robinolejnik/bosch-kf163-control/README.md

# bosch-kf163-control
Replacement PLL/TGA PCB to control Bosch KF83/KF163/KF453/KF165 radios
