robinolejnik/bosch-kf163-control/hardware/bosch-kf163-control.pdf

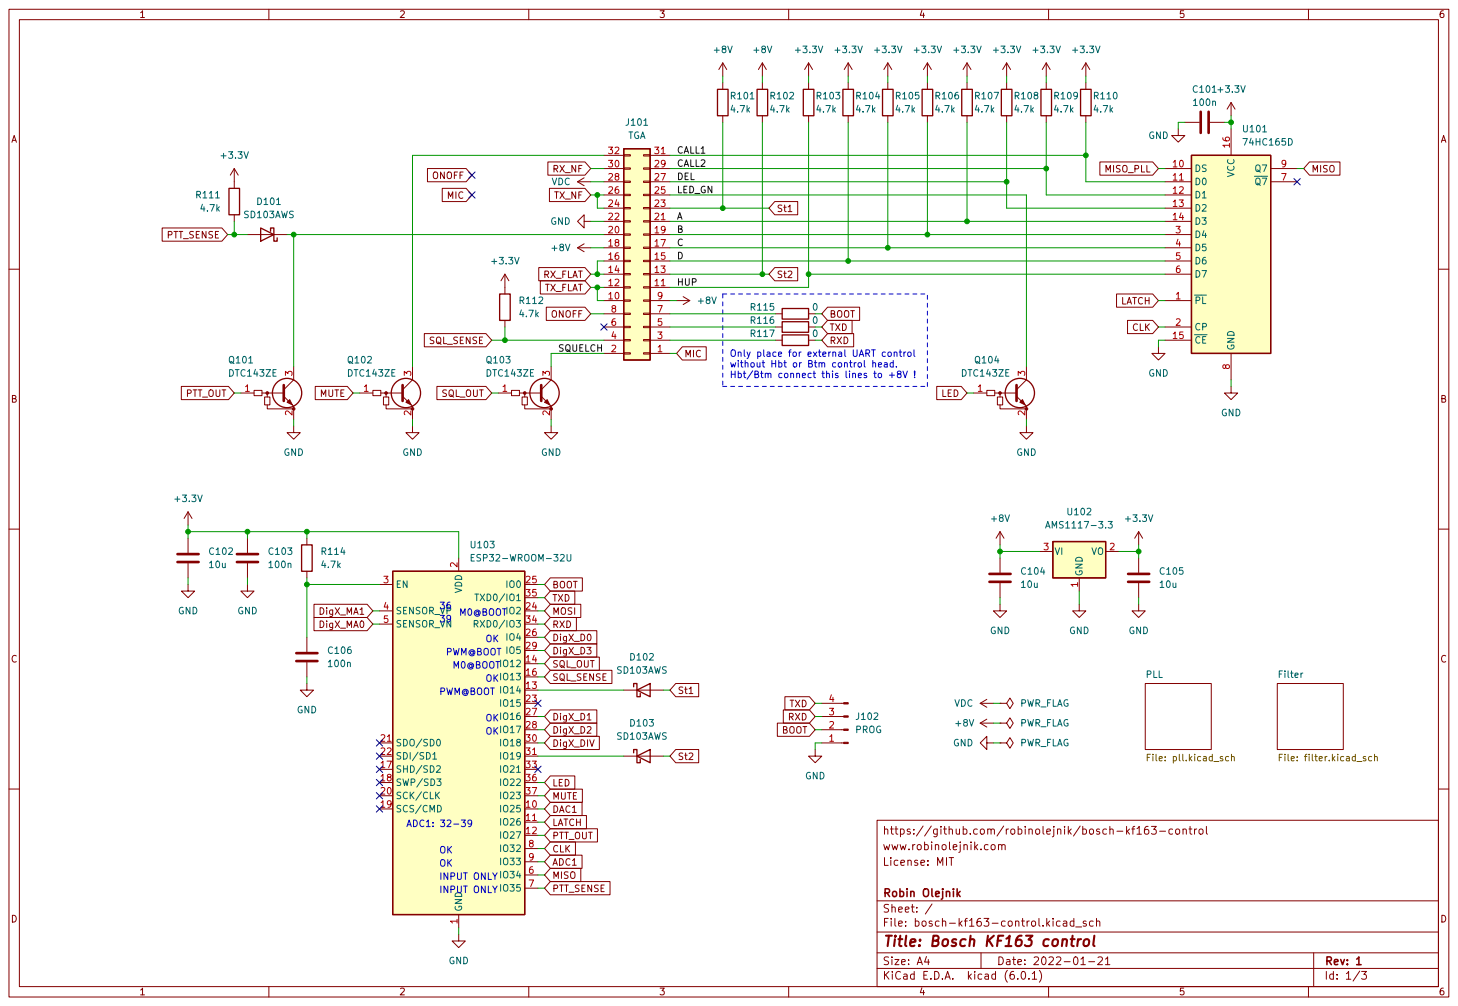
[picture p1: page 1]

CALL2 AHUP

18 +8V 16 SQUELCH 2 | 17 C

2 SCK/CLK 20 SDO/SD0 21 SDI/SD1 22

License: MIT www.robinolejnik.com

File: bosch-kf163-control.kicad_sch Sheet: / Robin Olejnik

Id: 1/3 Title: Bosch KF163 control

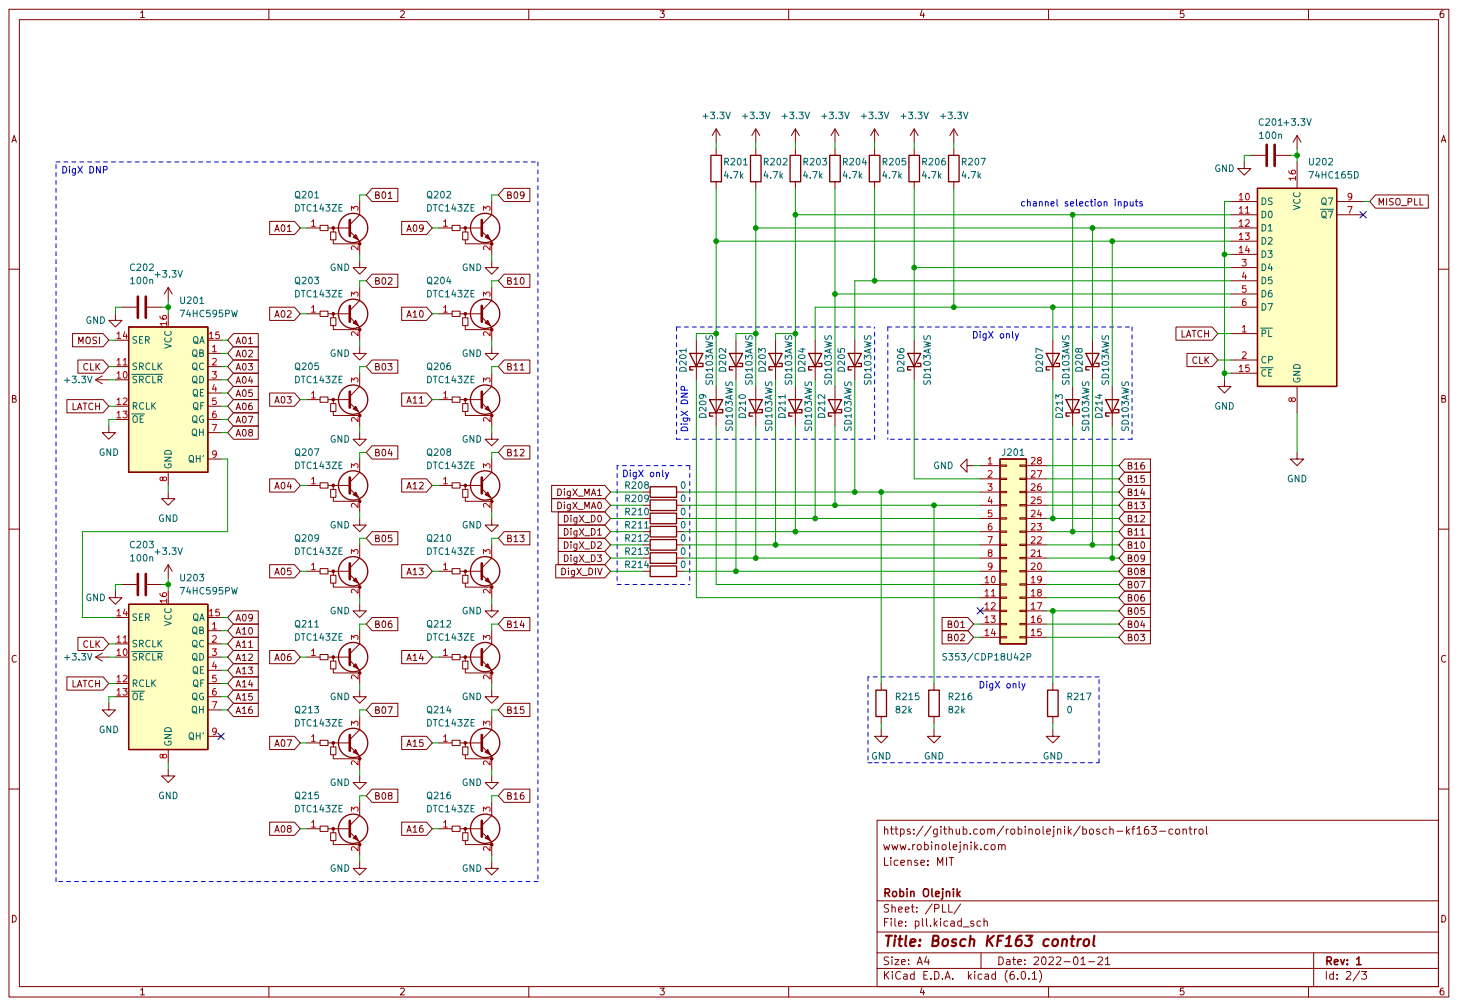
[picture p2: page 2]

2 3 Q204 DTC143ZE QB 1 ~{SRCLR} 10 SRCLK 11 RCLK 12 ~{OE} 13 SER 14 QA 15 VCC 16 QC 2 QD 3 QE 4 QF 5 QG 6 QH 7 GND

11
12

https://github.com/robinolejnik/bosch-kf163-control
License: MIT www.robinolejnik.com

File: pll.kicad_sch Sheet: /PLL/ Robin Olejnik

Id: 2/3 Title: Bosch KF163 control

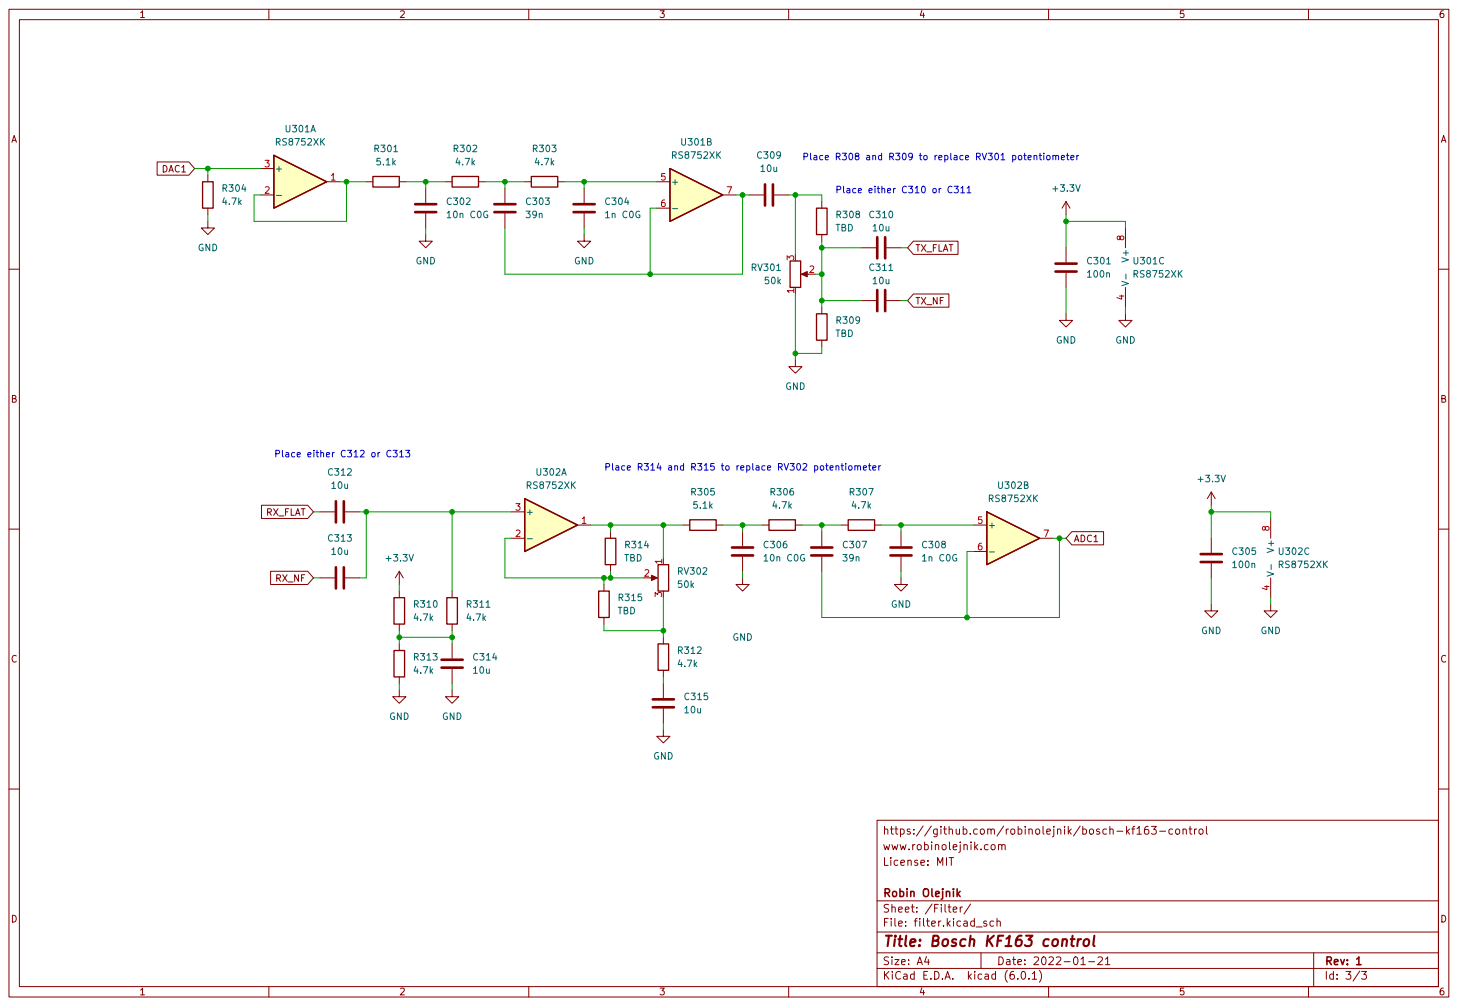
[picture p3: page 3]

https://github.com/robinolejnik/bosch-kf163-control GND GND

License: MIT www.robinolejnik.com

File: filter.kicad_sch Sheet: /Filter/ Robin Olejnik

Id: 3/3 Title: Bosch KF163 control
