robinolejnik/bosch-kf163-control/hardware/bosch-kf163-control.kicad_pcb

## KiCad design hardware/bosch-kf163-control.kicad_pcb (2022-01-21)

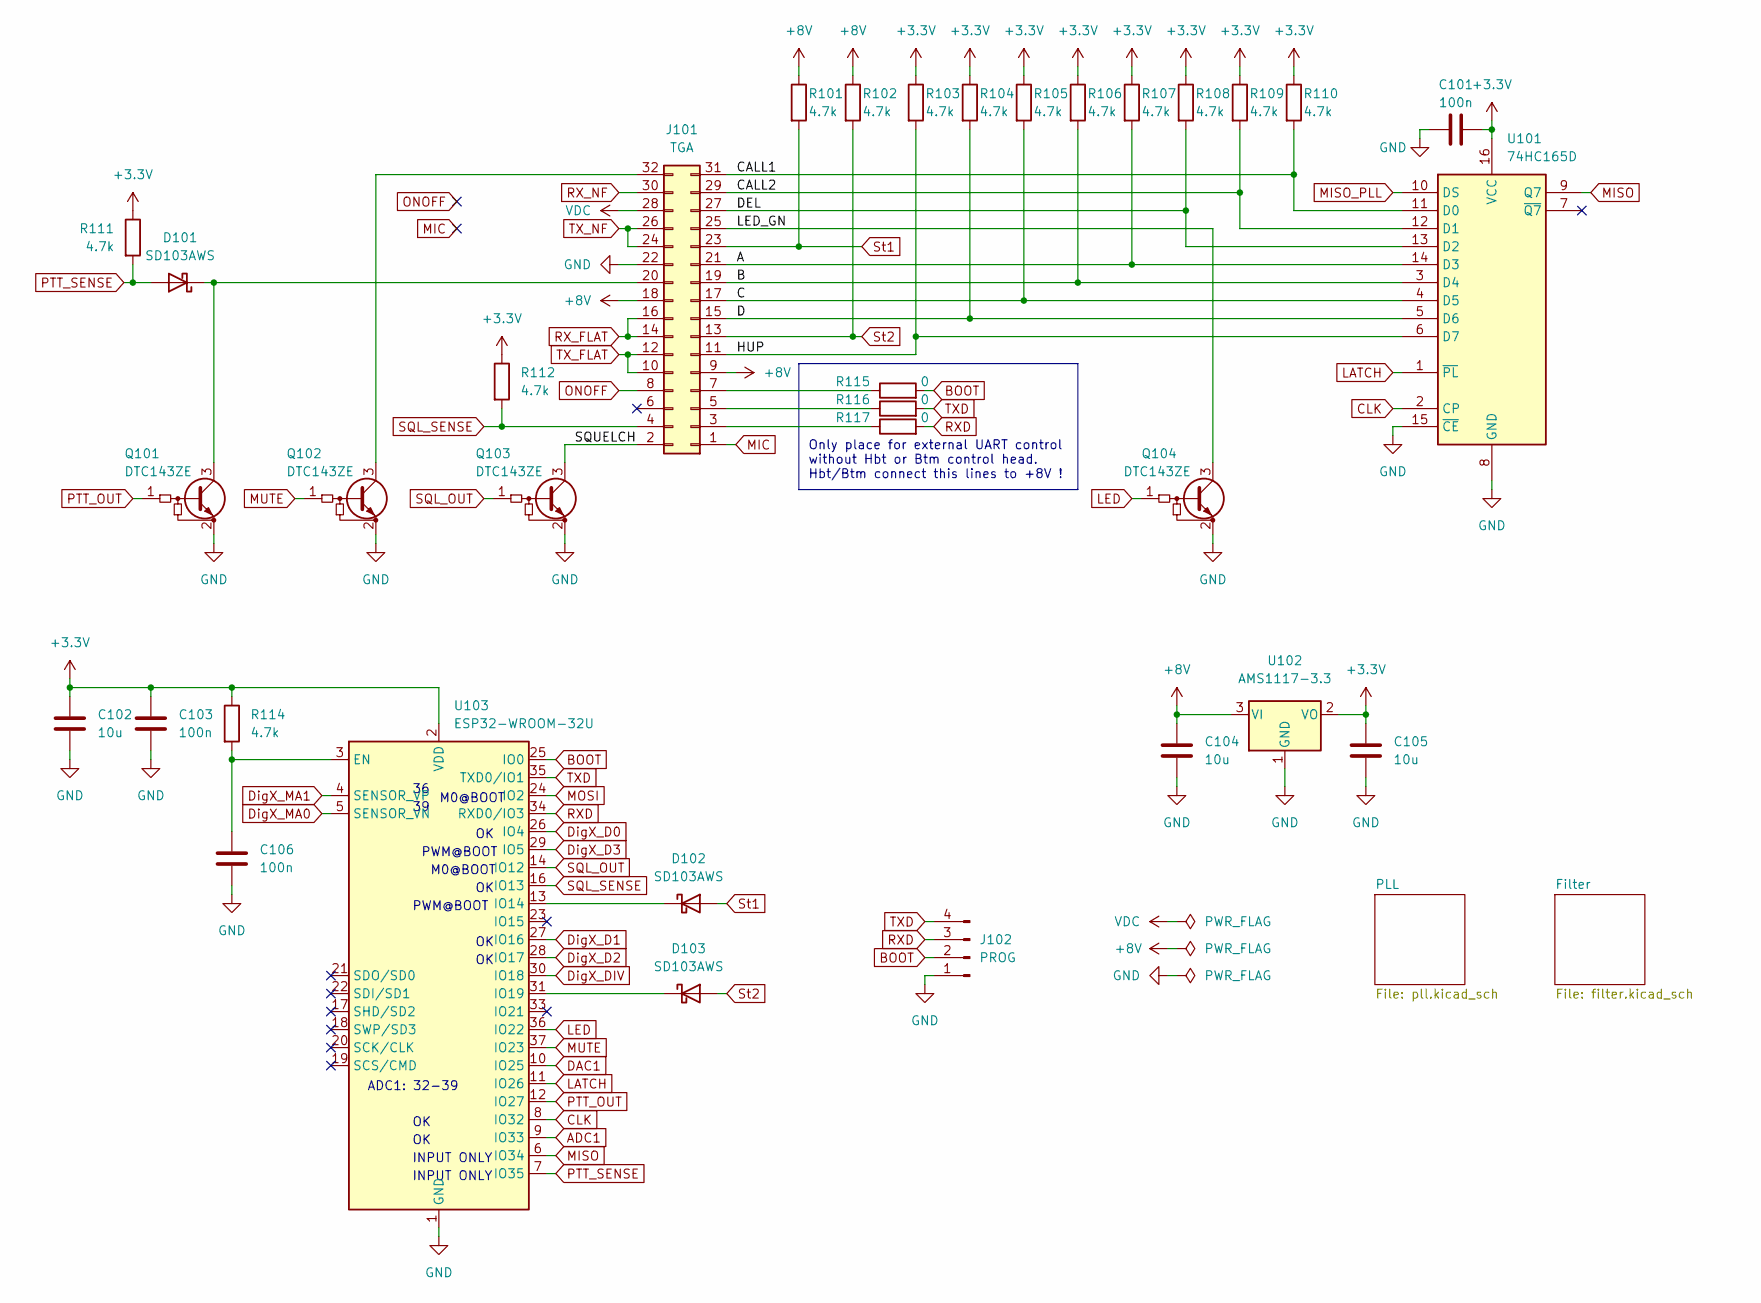
[picture p4: schematic bosch-kf163-control.kicad_sch, Bosch KF163 control]

Parts:
C101, C103, C106: 100n; C_0603_1608Metric; LCSC C14663
C102, C104, C105: 10u; C_0603_1608Metric; LCSC C2922482
D101, D102, D103: SD103AWS; D_SOD-323; LCSC C438010
J101: TGA; PinSocket_2x16_P2.54mm_Vertical; LCSC C115248
J102: PROG; PinHeader_1x04_P2.54mm_Vertical
Q101, Q102, Q103, Q104: DTC143ZE; SOT-523; LCSC C248787
R101, R102, R103, R104, R105, R106, R107, R108, R109, R110, R111, R112, R114: 4.7k; R_0603_1608Metric; LCSC C105428
R115, R116, R117: 0; R_0603_1608Metric; LCSC C100044
U101: 74HC165D; SOIC-16_3.9x9.9mm_P1.27mm; LCSC C5613
U102: AMS1117-3.3; SOT-223-3_TabPin2; LCSC C173386
U103: ESP32-WROOM-32U; LCSC C328062

Connections:
+3V3: C101.2, C102.1, C103.1, C105.1, R103.1, R104.1, R105.1, R106.1, R107.1, R108.1, R109.1, R110.1, R111.1, R112.1, R114.1, U101.16 (VCC), U102.2 (VO), U103.2 (VDD); also elsewhere on the board
+8V: C104.1, J101.9, J101.18, R101.1, R102.1, U102.3 (VI)
/A: J101.21, R107.2, U101.14 (D3)
/B: J101.19, R106.2, U101.3 (D4)
/C: J101.17, R105.2, U101.4 (D5)
/CALL1: J101.31, R110.2, U101.11 (D0)
/CALL2: J101.29, R109.2, U101.12 (D1)
/D: J101.15, R104.2, U101.5 (D6)
/DEL: J101.27, R108.2, U101.13 (D2)
/HUP: J101.11, R103.2, U101.6 (D7)
/LED_GN: J101.25, Q104.3 (C)
/SQUELCH: J101.2, Q103.3 (C)
ADC1: U103.9 (IO33); also elsewhere on the board
BOOT: J102.2, R115.2, U103.25 (IO0)
CLK: U101.2 (CP), U103.8 (IO32); also elsewhere on the board
DAC1: U103.10 (IO25); also elsewhere on the board
DigX_D0: U103.26 (IO4); also elsewhere on the board
DigX_D1: U103.27 (IO16); also elsewhere on the board
DigX_D2: U103.28 (IO17); also elsewhere on the board
DigX_D3: U103.29 (IO5); also elsewhere on the board
DigX_DIV: U103.30 (IO18); also elsewhere on the board
DigX_MA0: U103.5 (SENSOR_VN); also elsewhere on the board
DigX_MA1: U103.4 (SENSOR_VP); also elsewhere on the board
GND: C101.1, C102.2, C103.2, C104.2, C105.2, C106.2, J101.22, J102.1, Q101.2 (E), Q102.2 (E), Q103.2 (E), Q104.2 (E), U101.8 (GND), U101.15 (~CE), U102.1 (GND), U103.1 (GND), U103.15 (GND), U103.38 (GND), U103.39 (GND); also elsewhere on the board
LATCH: U101.1 (~PL), U103.11 (IO26); also elsewhere on the board
LED: Q104.1 (B), U103.36 (IO22)
MIC: J101.1
MISO: U101.9 (Q7), U103.6 (IO34)
MISO_PLL: U101.10 (DS); also elsewhere on the board
MOSI: U103.24 (IO2); also elsewhere on the board
MUTE: Q102.1 (B), U103.37 (IO23)
unnamed: C106.1, R114.2, U103.3 (EN)
unnamed: D101.1 (K), J101.20, Q101.3 (C)
unnamed: D102.1 (K), U103.13 (IO14)
unnamed: D103.1 (K), U103.31 (IO19)
unnamed: J101.3, R117.1
unnamed: J101.5, R116.1
unnamed: J101.7, R115.1
unnamed: J101.32, Q102.3 (C)
ONOFF: J101.8
PTT_OUT: Q101.1 (B), U103.12 (IO27)
PTT_SENSE: D101.2 (A), R111.2, U103.7 (IO35)
RXD: J102.3, R117.2, U103.34 (RXD0/IO3)
RX_FLAT: J101.14, J101.16; also elsewhere on the board
RX_NF: J101.30; also elsewhere on the board
SQL_OUT: Q103.1 (B), U103.14 (IO12)
SQL_SENSE: J101.4, R112.2, U103.16 (IO13)
St1: D102.2 (A), J101.23, R101.2
St2: D103.2 (A), J101.13, R102.2
TXD: J102.4, R116.2, U103.35 (TXD0/IO1)
TX_FLAT: J101.10, J101.12; also elsewhere on the board
TX_NF: J101.24, J101.26; also elsewhere on the board
VDC: J101.28

Notes on the sheet:
ADC1: 32-39
M0@BOOT
INPUT ONLY
PWM@BOOT
Only place for external UART control without Hbt or Btm control head. Hbt/Btm connect this lines to +8V !

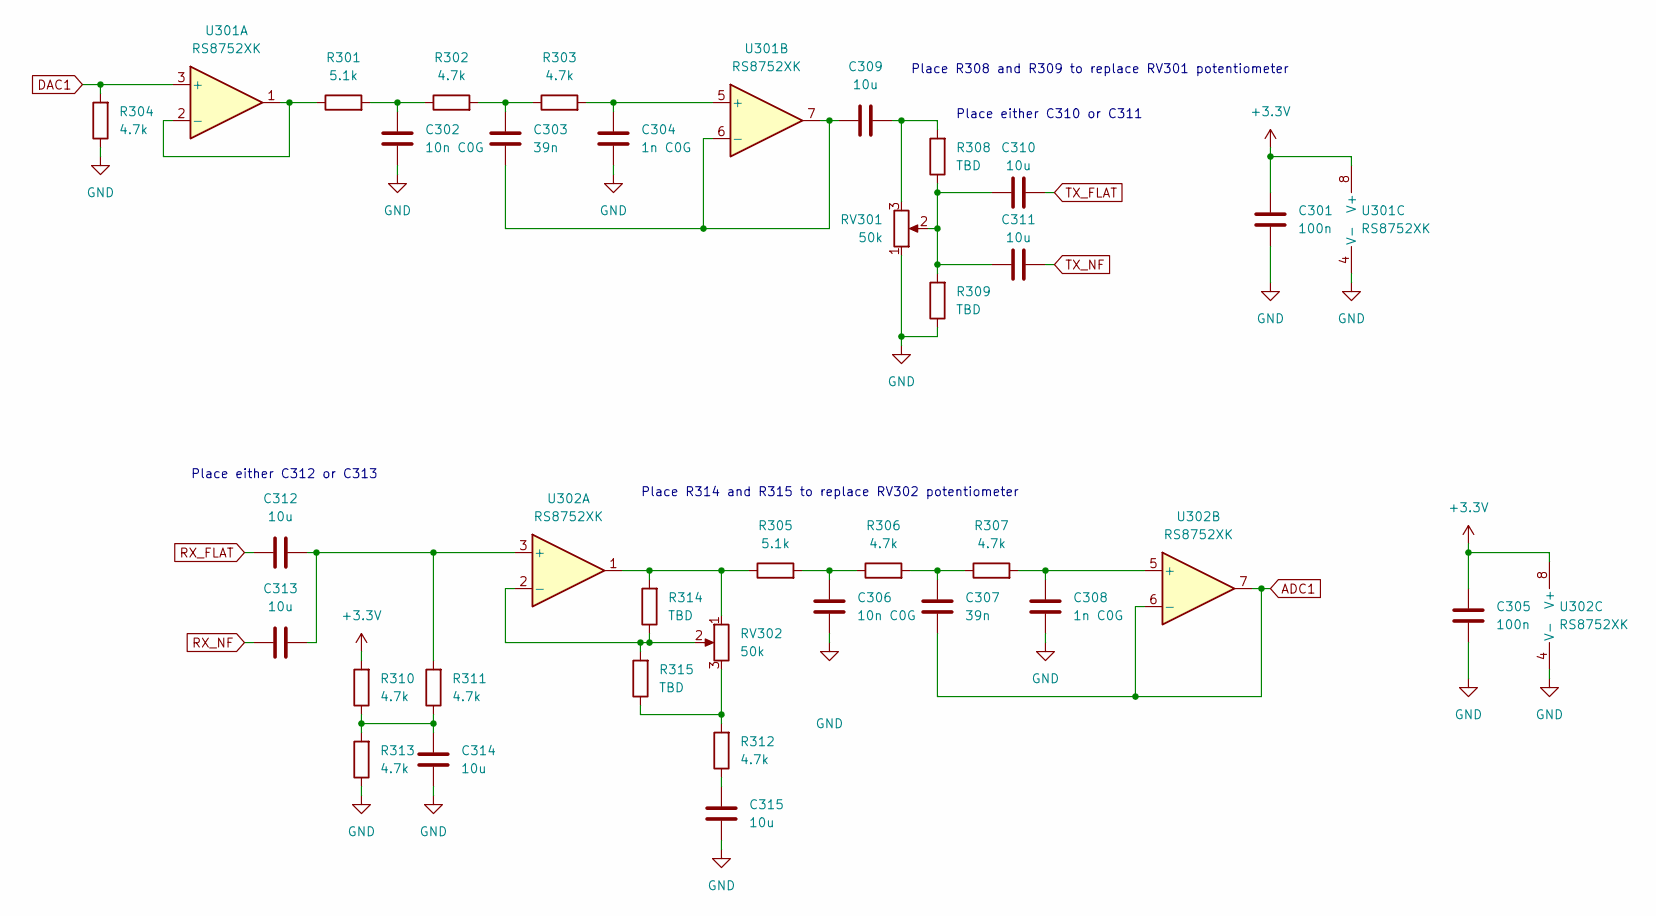
[picture p5: schematic filter.kicad_sch, Bosch KF163 control]

Parts:
C301, C305: 100n; C_0603_1608Metric; LCSC C14663
C302, C306: 10n C0G; C_0603_1608Metric; LCSC C389113
C303, C307: 39n; C_0603_1608Metric; LCSC C107091
C304, C308: 1n C0G; C_0603_1608Metric; LCSC C106246
C309, C310, C311, C312, C313, C314, C315: 10u; C_0603_1608Metric; LCSC C2922482
R301, R305: 5.1k; R_0603_1608Metric; LCSC C23186
R302, R303, R304, R306, R307, R310, R311, R312, R313: 4.7k; R_0603_1608Metric; LCSC C105428
R308, R309, R314, R315: TBD; R_0603_1608Metric
RV301, RV302: 50k; Potentiometer_Bourns_TC33X_Vertical; LCSC C145161
U301, U302: RS8752XK; SOIC-8_3.9x4.9mm_P1.27mm; LCSC C236994

Connections:
+3V3: C301.1, C305.1, R310.2, U301.8 (V+), U302.8 (V+); also elsewhere on the board
ADC1: C307.2, U302.6 (-), U302.7; also elsewhere on the board
DAC1: R304.2, U301.3 (+); also elsewhere on the board
GND: C301.2, C302.2, C304.2, C305.2, C306.2, C308.2, C314.2, C315.2, R304.1, R309.1, R313.1, RV301.1, U301.4 (V-), U302.4 (V-); also elsewhere on the board
unnamed: C302.1, R301.2, R302.1
unnamed: C303.1, R302.2, R303.1
unnamed: C303.2, C309.1, U301.6 (-), U301.7
unnamed: C304.1, R303.2, U301.5 (+)
unnamed: C306.1, R305.2, R306.1
unnamed: C307.1, R306.2, R307.1
unnamed: C308.1, R307.2, U302.5 (+)
unnamed: C309.2, R308.2, RV301.3
unnamed: C310.1, C311.1, R308.1, R309.2, RV301.2
unnamed: C312.2, C313.2, R311.2, U302.3 (+)
unnamed: C314.1, R310.1, R311.1, R313.2
unnamed: C315.1, R312.1
unnamed: R301.1, U301.1, U301.2 (-)
unnamed: R305.1, R314.2, RV302.1, U302.1
unnamed: R312.2, R315.1, RV302.3
unnamed: R314.1, R315.2, RV302.2, U302.2 (-)
RX_FLAT: C312.1; also elsewhere on the board
RX_NF: C313.1; also elsewhere on the board
TX_FLAT: C310.2; also elsewhere on the board
TX_NF: C311.2; also elsewhere on the board

Notes on the sheet:
Place R308 and R309 to replace RV301 potentiometer
Place either C310 or C311
Place R314 and R315 to replace RV302 potentiometer
Place either C312 or C313

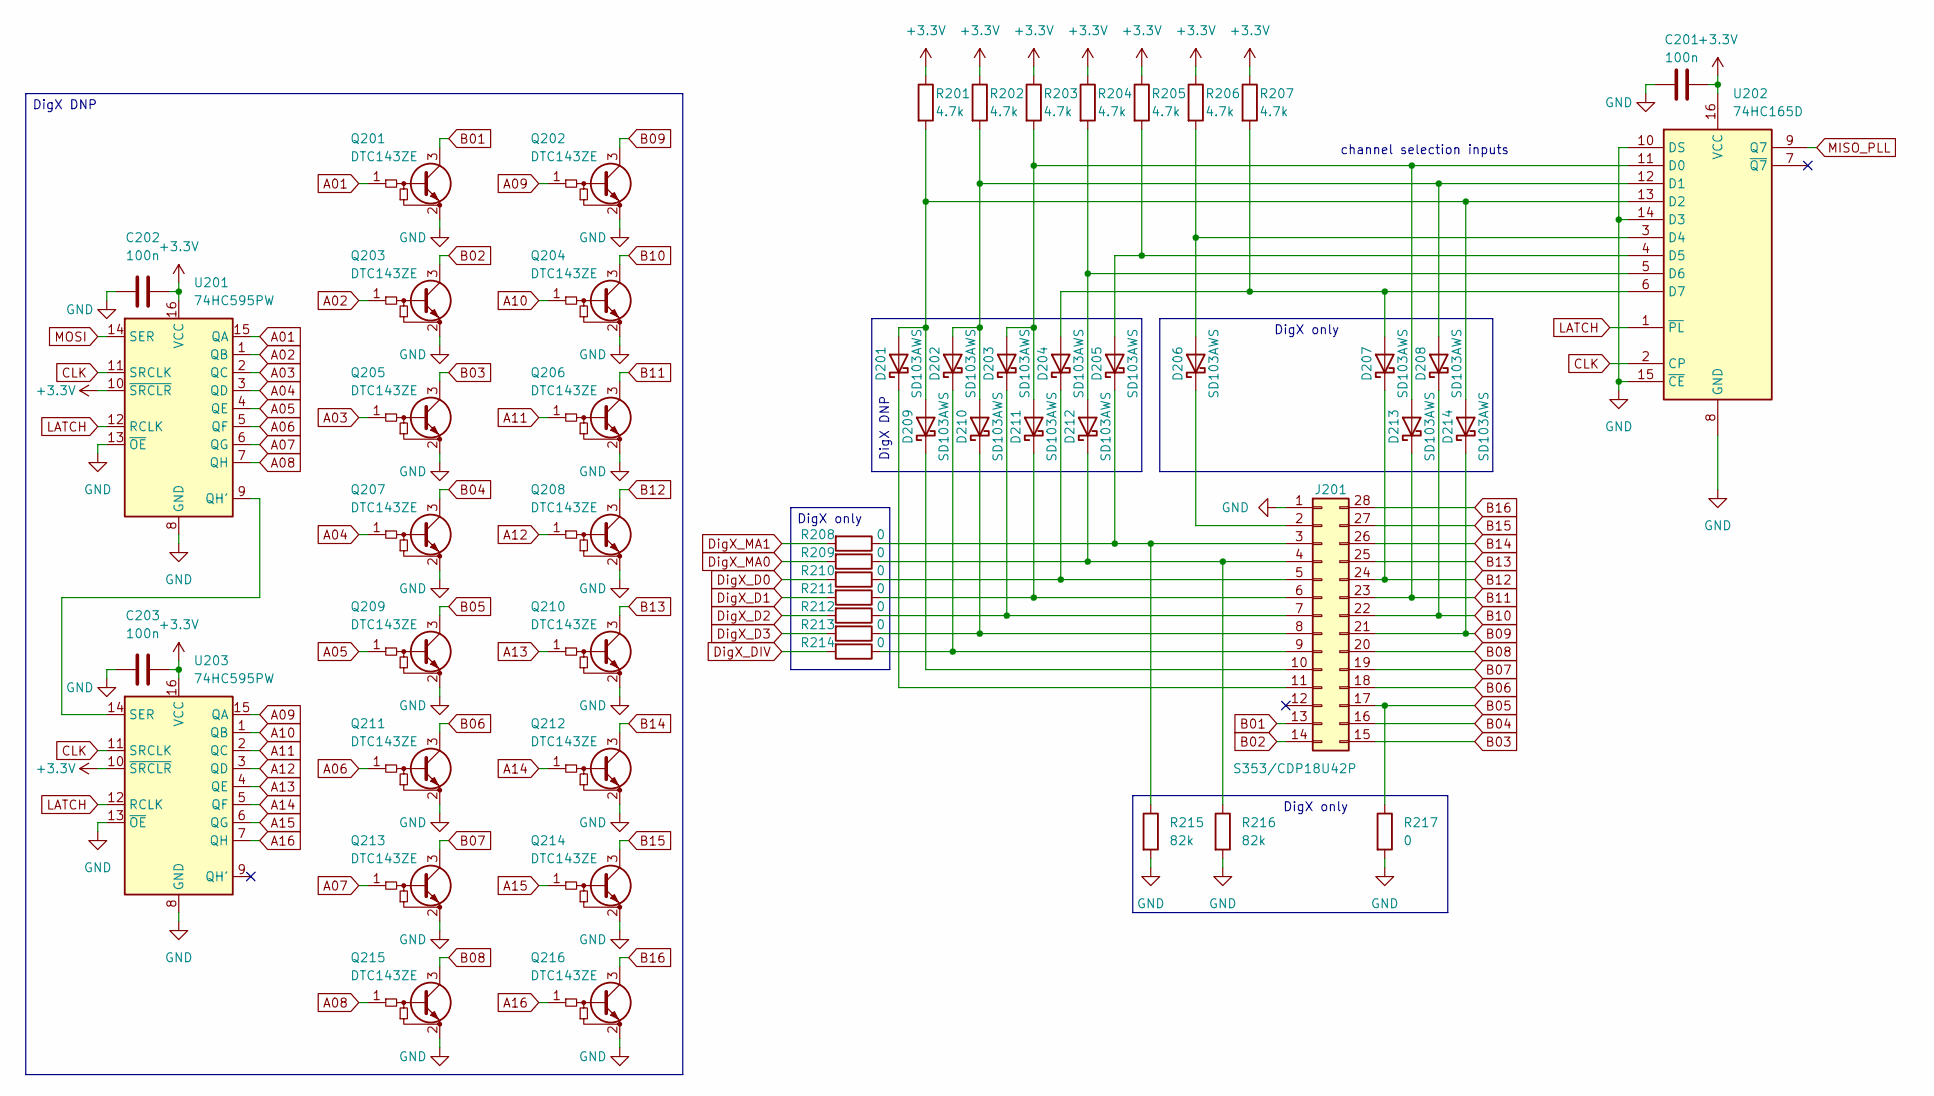
[picture p6: schematic pll.kicad_sch, Bosch KF163 control]

Parts:
C201, C202, C203: 100n; C_0603_1608Metric; LCSC C14663
D201, D202, D203, D204, D205, D206, D207, D208, D209, D210, D211, D212, D213, D214: SD103AWS; D_SOD-323; LCSC C438010
J201: S353/CDP18U42P; DIP-28_W15.24mm_Socket_LongPads; LCSC C510960
Q201, Q202, Q203, Q204, Q205, Q206, Q207, Q208, Q209, Q210, Q211, Q212, Q213, Q214, Q215, Q216: DTC143ZE; SOT-523; LCSC C248787
R201, R202, R203, R204, R205, R206, R207: 4.7k; R_0603_1608Metric; LCSC C105428
R208, R209, R210, R211, R212, R213, R214, R217: 0; R_0603_1608Metric; LCSC C100044
R215, R216: 82k; R_0603_1608Metric; LCSC C103831
U201, U203: 74HC595PW; TSSOP-16_4.4x5mm_P0.65mm; LCSC C5948
U202: 74HC165D; SOIC-16_3.9x9.9mm_P1.27mm; LCSC C5613

Connections:
+3V3: C201.2, C202.2, C203.2, R201.1, R202.1, R203.1, R204.1, R205.1, R206.1, R207.1, U201.10 (~SRCLR), U201.16 (VCC), U202.16 (VCC), U203.10 (~SRCLR), U203.16 (VCC); also elsewhere on the board
A01: Q201.1 (B), U201.15 (QA)
A02: Q203.1 (B), U201.1 (QB)
A03: Q205.1 (B), U201.2 (QC)
A04: Q207.1 (B), U201.3 (QD)
A05: Q209.1 (B), U201.4 (QE)
A06: Q211.1 (B), U201.5 (QF)
A07: Q213.1 (B), U201.6 (QG)
A08: Q215.1 (B), U201.7 (QH)
A09: Q202.1 (B), U203.15 (QA)
A10: Q204.1 (B), U203.1 (QB)
A11: Q206.1 (B), U203.2 (QC)
A12: Q208.1 (B), U203.3 (QD)
A13: Q210.1 (B), U203.4 (QE)
A14: Q212.1 (B), U203.5 (QF)
A15: Q214.1 (B), U203.6 (QG)
A16: Q216.1 (B), U203.7 (QH)
B01: J201.13, Q201.3 (C)
B02: J201.14, Q203.3 (C)
B03: J201.15, Q205.3 (C)
B04: J201.16, Q207.3 (C)
B05: J201.17, Q209.3 (C), R217.1
B06: J201.18, Q211.3 (C)
B07: J201.19, Q213.3 (C)
B08: J201.20, Q215.3 (C)
B09: D214.1 (K), J201.21, Q202.3 (C)
B10: D208.1 (K), J201.22, Q204.3 (C)
B11: D213.1 (K), J201.23, Q206.3 (C)
B12: D207.1 (K), J201.24, Q208.3 (C)
B13: J201.25, Q210.3 (C)
B14: J201.26, Q212.3 (C)
B15: J201.27, Q214.3 (C)
B16: J201.28, Q216.3 (C)
CLK: U201.11 (SRCLK), U202.2 (CP), U203.11 (SRCLK); also elsewhere on the board
DigX_D0: R210.2; also elsewhere on the board
DigX_D1: R211.2; also elsewhere on the board
DigX_D2: R212.2; also elsewhere on the board
DigX_D3: R213.2; also elsewhere on the board
DigX_DIV: R214.2; also elsewhere on the board
DigX_MA0: R209.2; also elsewhere on the board
DigX_MA1: R208.2; also elsewhere on the board
GND: C201.1, C202.1, C203.1, J201.1, Q201.2 (E), Q202.2 (E), Q203.2 (E), Q204.2 (E), Q205.2 (E), Q206.2 (E), Q207.2 (E), Q208.2 (E), Q209.2 (E), Q210.2 (E), Q211.2 (E), Q212.2 (E), Q213.2 (E), Q214.2 (E), Q215.2 (E), Q216.2 (E), R215.2, R216.2, R217.2, U201.8 (GND), U201.13 (~OE), U202.8 (GND), U202.10 (DS), U202.14 (D3), U202.15 (~CE), U203.8 (GND), U203.13 (~OE); also elsewhere on the board
LATCH: U201.12 (RCLK), U202.1 (~PL), U203.12 (RCLK); also elsewhere on the board
MISO_PLL: U202.9 (Q7); also elsewhere on the board
MOSI: U201.14 (SER); also elsewhere on the board
unnamed: D201.1 (K), J201.11
unnamed: D201.2 (A), D209.2 (A), D214.2 (A), R201.2, U202.13 (D2)
unnamed: D202.1 (K), J201.9, R214.1
unnamed: D202.2 (A), D208.2 (A), D210.2 (A), R202.2, U202.12 (D1)
unnamed: D203.1 (K), J201.7, R212.1
unnamed: D203.2 (A), D211.2 (A), D213.2 (A), R203.2, U202.11 (D0)
unnamed: D204.1 (K), J201.5, R210.1
unnamed: D204.2 (A), D207.2 (A), R207.2, U202.6 (D7)
unnamed: D205.1 (K), J201.3, R208.1, R215.1
unnamed: D205.2 (A), R205.2, U202.4 (D5)
unnamed: D206.1 (K), J201.2
unnamed: D206.2 (A), R206.2, U202.3 (D4)
unnamed: D209.1 (K), J201.10
unnamed: D210.1 (K), J201.8, R213.1
unnamed: D211.1 (K), J201.6, R211.1
unnamed: D212.1 (K), J201.4, R209.1, R216.1
unnamed: D212.2 (A), R204.2, U202.5 (D6)
unnamed: U201.9 (QH'), U203.14 (SER)

Notes on the sheet:
DigX only
DigX DNP
channel selection inputs

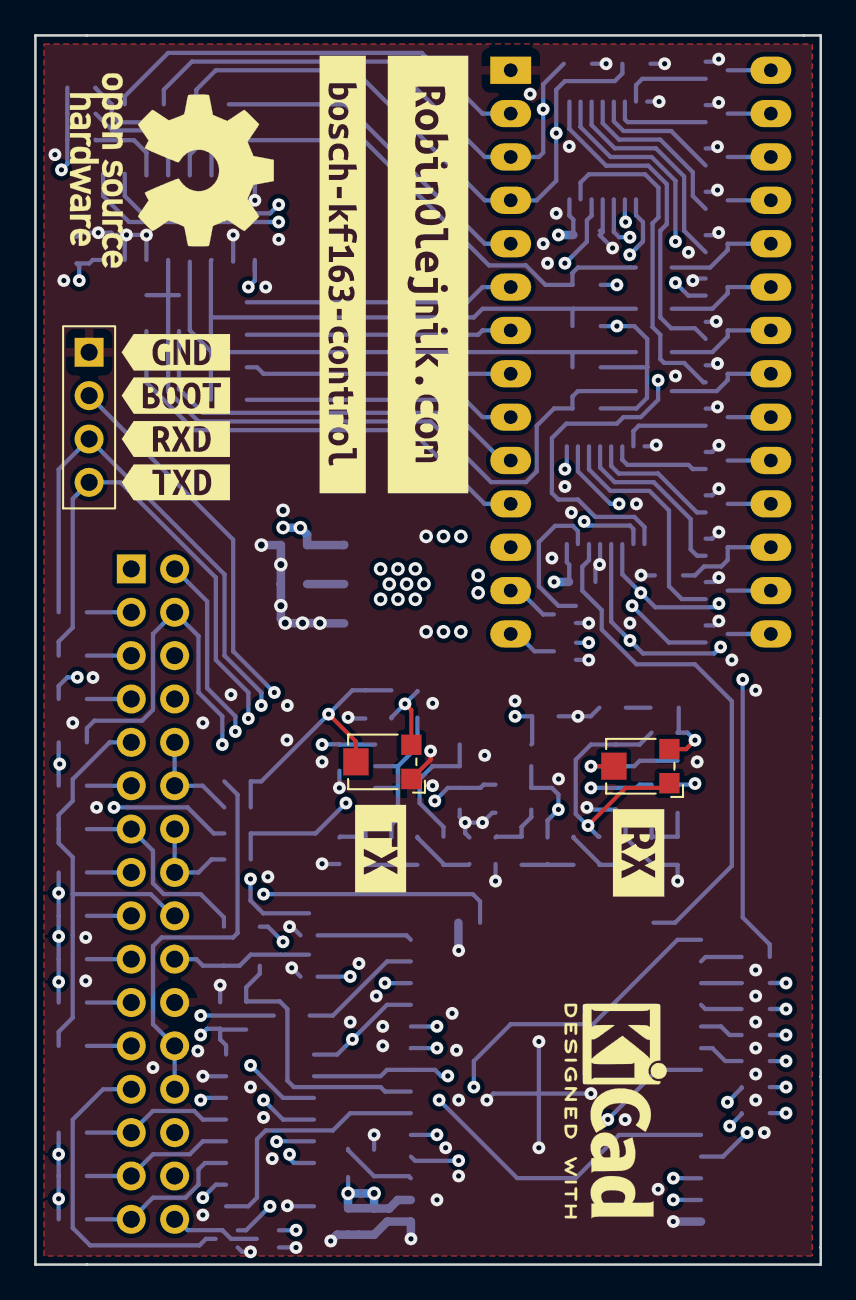
[picture p7: board bosch-kf163-control.kicad_pcb from above]

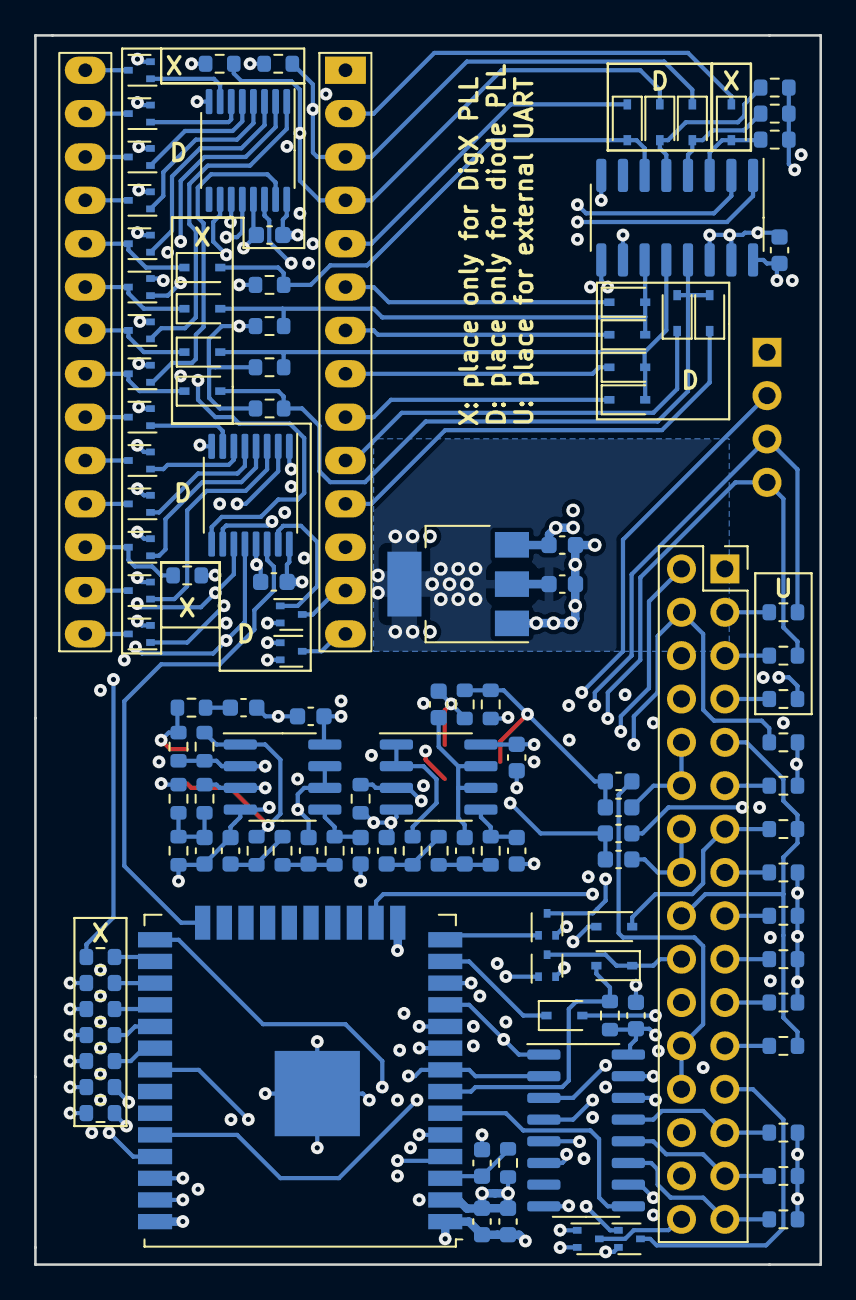
[picture p8: board bosch-kf163-control.kicad_pcb from below]

Board: 4 copper layers, 46.0 x 72.0 mm, 130 parts (119 on the bottom side), 116 nets.

Other parts of the board:
kibuzzard-61EB12C7: G***; kibuzzard-61EB12C7
kibuzzard-61EB12DB: G***; kibuzzard-61EB12DB
kibuzzard-61EB14A1: G***; kibuzzard-61EB14A1
kibuzzard-61EB122B: G***; kibuzzard-61EB122B
kibuzzard-61EB123A: G***; kibuzzard-61EB123A
kibuzzard-61EB1225: G***; kibuzzard-61EB1225
kibuzzard-61EB1233: G***; kibuzzard-61EB1233
kibuzzard-61EB1504: G***; kibuzzard-61EB1504
