robinolejnik/bosch-kf163-control/(commit log)

2022-01-08 initial pll circuit
    [bosch-kf163-pll.kicad_pcb, bosch-kf163-pll.kicad_sch, pll.kicad_sch]
2022-01-11 Initial TGA-connector, ESP32 and NF-filter circuit.
    [bosch-kf163-pll.kicad_sch, filter.kicad_sch, pll.kicad_sch]
2022-01-14 schematic/pcb update
    [bosch-kf163-pll.kicad_pcb, bosch-kf163-pll.kicad_sch, filter.kicad_sch, pll.kicad_sch]
2022-01-20 Finished schematic (BOM consolidation, LCSC part numbers) + sheet comments
    [bosch-kf163-pll.kicad_sch, filter.kicad_sch, pll.kicad_sch]
2022-01-20 renamed project to bosch-kf163-control
    [bosch-kf163-control.kicad_pcb, bosch-kf163-control.kicad_sch]
2022-01-20 sheet comments, schematic variants, removed txd resistor
    [bosch-kf163-control.kicad_pcb, bosch-kf163-control.kicad_sch, filter.kicad_sch, pll.kicad_sch]
2022-01-21 silkscreen symbols and text, various schematic/pcb updates
    [bosch-kf163-control.kicad_pcb, bosch-kf163-control.kicad_sch, filter.kicad_sch, pll.kicad_sch]
2022-01-21 Added pdf schematic and pcb gerber files
    [bosch-kf163-control-B_Cu.gbl, bosch-kf163-control-B_Mask.gbs, bosch-kf163-control-B_Paste.gbp, bosch-kf163-control-B_Silkscreen.gbo, bosch-kf163-control-Edge_Cuts.gm1, bosch-kf163-control-F_Cu.gtl, bosch-kf163-control-F_Mask.gts, bosch-kf163-control-F_Paste.gtp]
2022-04-27 Moved KiCad files to hardware folder.
    [bosch-kf163-control-B_Cu.gbl, bosch-kf163-control-B_Mask.gbs, bosch-kf163-control-B_Paste.gbp, bosch-kf163-control-B_Silkscreen.gbo, bosch-kf163-control-Edge_Cuts.gm1, bosch-kf163-control-F_Cu.gtl, bosch-kf163-control-F_Mask.gts, bosch-kf163-control-F_Paste.gtp]
2022-04-27 Added ESP32 firmware frame
2022-04-29 initial KF163 diode pll code
2023-06-05 Read from shift registers, use call1 button as PTT
